soso1999/esp32-s3-ha-voice-satellite/docs/PUBLISHING.md

# Publishing

The owner approved the public GitHub repository `soso1999/esp32-s3-ha-voice-satellite` on 2026-10-15.

Repository: https://github.com/soso1999/esp32-s3-ha-voice-satellite

The repository now uses explicit dual licensing: software, ESPHome YAML files and scripts are licensed under the MIT License; CAD files, 3D models, schematics, documentation, photographs and other non-software content are licensed under the Creative Commons Attribution-ShareAlike 4.0 International License (CC BY-SA 4.0). See `LICENSE.md`, `LICENSE-MIT` and `LICENSE-CC-BY-SA-4.0`.

Do not commit populated secrets or private model/server logs. Revalidate ESPHome configuration after firmware changes, and update documentation and checksums when replacing artifacts. `docs/MANIFEST.sha256` records the packaged project files except itself.

## Upload this update

Unzip the supplied package locally, open its `esp32-s3-ha-voice-satellite` folder, and upload its **contents** to the root of the existing repository. Do not upload the ZIP itself as the source update or add a second nested project folder. Include the hidden `.github` folder (funding button) and `.gitignore`; some file pickers hide them. GitHub's upload page accepts files/folders via drag and drop. Verify that `.github/FUNDING.yml` is included before committing. If your file picker hides it, create that file through GitHub's “Add file → Create new file” with the contents from the package. No existing files need deletion.

The README support links work independently of GitHub's funding button. If the Sponsor button does not appear, check repository Settings → General → Features → Sponsorships.

Keep the repository name `esp32-s3-ha-voice-satellite`. Suggested description: “DIY ESP32-S3 Home Assistant voice satellite with ESPHome, local wake words, Qwen conversation and a 3D-printed enclosure.” Suggested topics: `esp32-s3`, `home-assistant`, `esphome`, `voice-assistant`, `voice-satellite`, `smart-speaker`, `micro-wake-word`, `i2s`, `openscad`, `3d-printing`, `qwen`, `diy-electronics`. Description and topics are repository settings; uploading files does not apply them.
