soso1999/esp32-s3-ha-voice-satellite/docs/PROVENANCE.md

# Source provenance

Prepared 2026-10-15 from the user's referenced conversation “KI in Home Assistant integrieren” and its attachments, plus the actual earlier enclosure work project. No remembered GA-headset or printer-card data was used.

- Final firmware: last complete Stop-enabled YAML, conversation turn 67bad795-94a8-45a2-8aa1-3ab72d7b8fe8. Preserved unchanged; later sensitivity suggestions were not treated as applied changes.
- Operational confirmation: subsequent user reported Stop worked with lower speaker volume and later reported the overall system working well.
- Photos: final four-image upload, turn cf4db80a-133a-451b-a309-d247fd397ab7.
- CAD: original v0.4 files from the earlier work project's `outputs/v04`; cross-checked against the uploaded `esp32_s3_gehaeuse_v04.zip`.
- Physical dimensions: user measurements from the conversation and current request. Coordinate corrections and discrepancies are explicit in `hardware/DIMENSIONS.md`.
- External setup guidance: official ESPHome and Home Assistant documentation checked on packaging date; linked in the relevant guides.

Unresolved details: exact memory module marking/PSRAM capacity, speaker impedance/power, amplifier power/control straps, screw lengths, specific filament/slicer settings of the photographed build, and definitive photo-to-CAD-revision identification. These are not filled with guessed as-built values.
