soso1999/esp32-s3-ha-voice-satellite/images/README.md

# Original build photographs

These four original photographs document the completed ESP32-S3 Home Assistant voice satellite. Only one image is shown on the main repository page to keep the README compact; the complete photo set is collected here.

<p align="center">
  Completed build photo 1
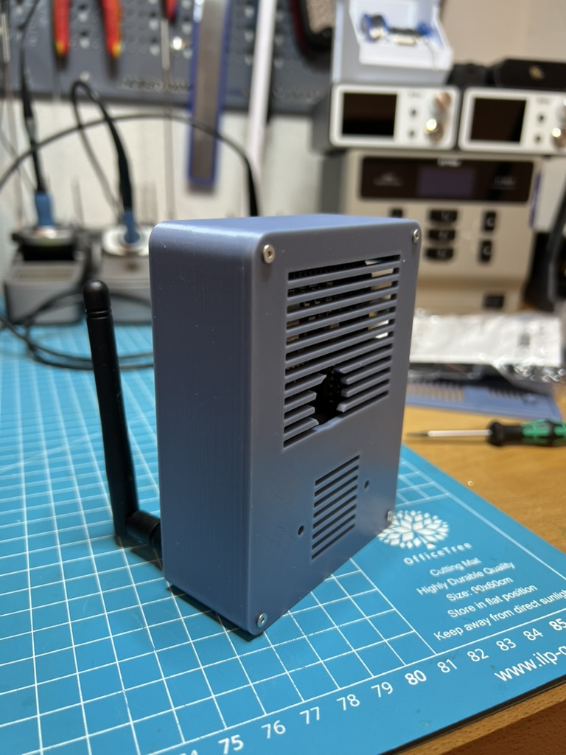
[picture p3: images/build-02.jpeg]
Completed build photo 2
  
</p>

<p align="center">
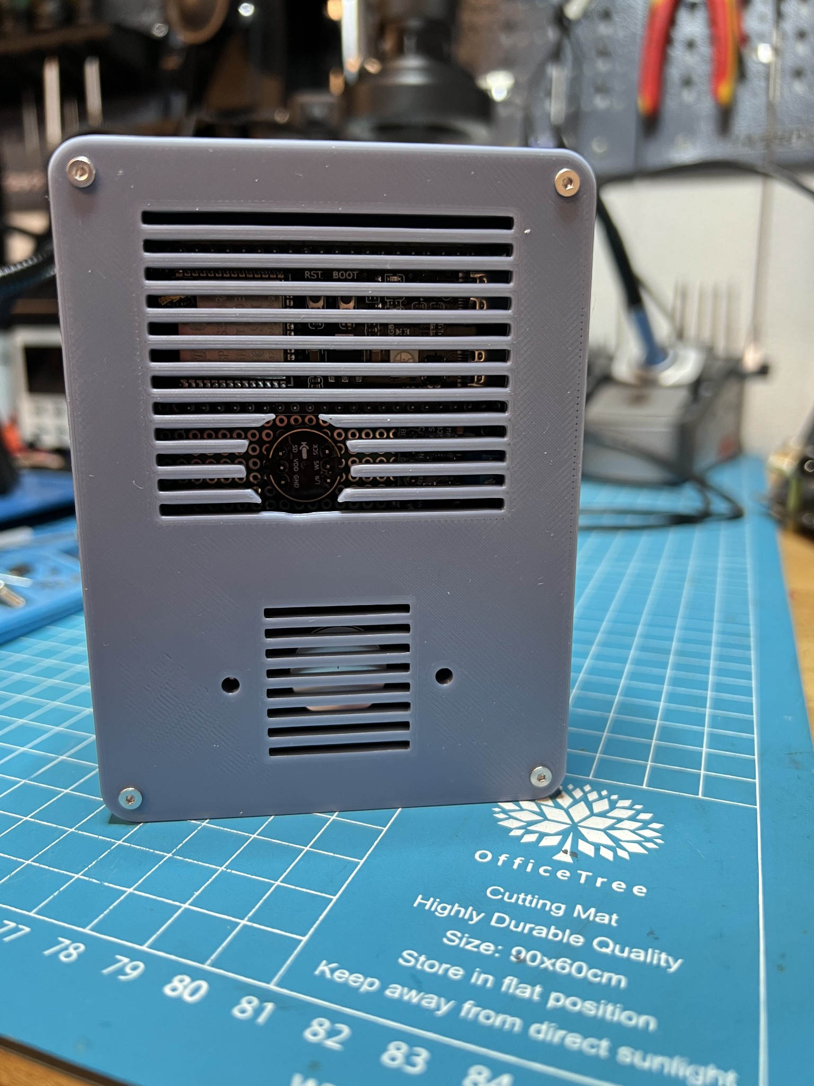
[picture p4: images/build-03.jpg]
Completed build photo 3
  
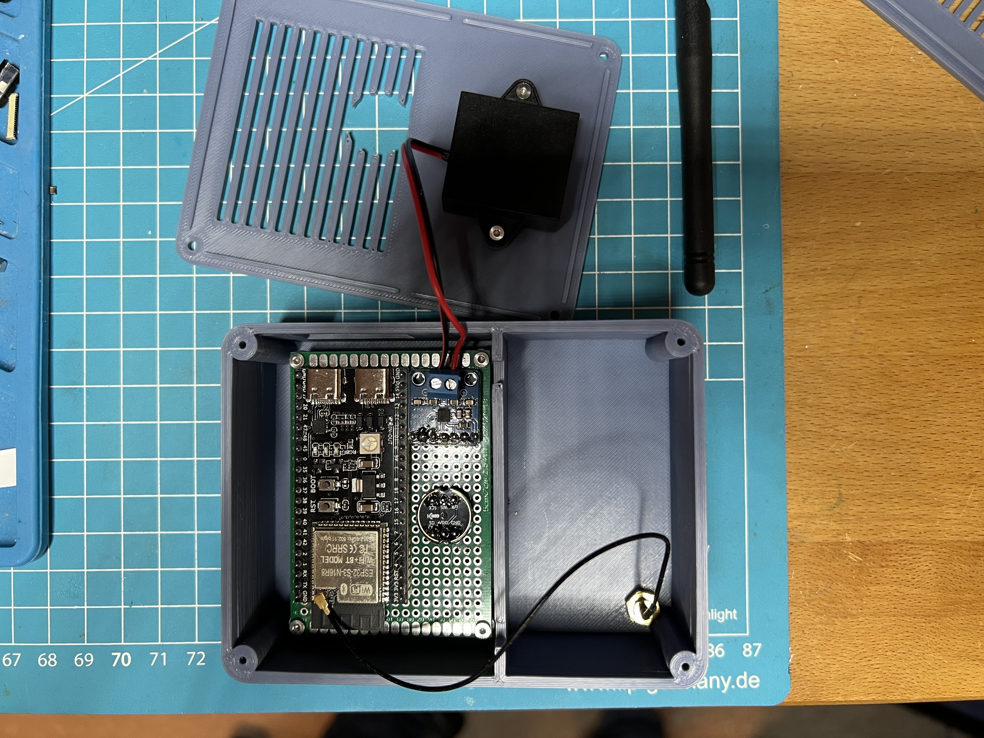
[picture p5: images/build-04.jpg]
Completed build photo 4
  
</p>

## Source files

| Repository file | Original upload |
|---|---|
| `build-01.jpg` | `7EC12A70-4D43-49C6-8FD5-4E7C34E6F7DB.jpg` |
| `build-02.jpeg` | `1B6475AA-E182-4687-AE4E-AAE392DCF8B9_1_105_c.jpeg` |
| `build-03.jpg` | `7204F435-1779-4278-9362-54A0A67C3396.jpg` |
| `build-04.jpg` | `94616138-20AB-4155-9980-914AF7618AA6.jpg` |

SHA-256 hashes in `../docs/MANIFEST.sha256` allow verification of the repository files.

## License

These photographs are licensed under the **Creative Commons Attribution-ShareAlike 4.0 International License (CC BY-SA 4.0)** as part of the repository's non-software content.

See [`../LICENSE.md`](../LICENSE.md) and [`../LICENSE-CC-BY-SA-4.0`](../LICENSE-CC-BY-SA-4.0) for details.

Copyright © 2026 soso1999.
