soso1999/esp32-s3-ha-voice-satellite/cad/massskizze_v04.png

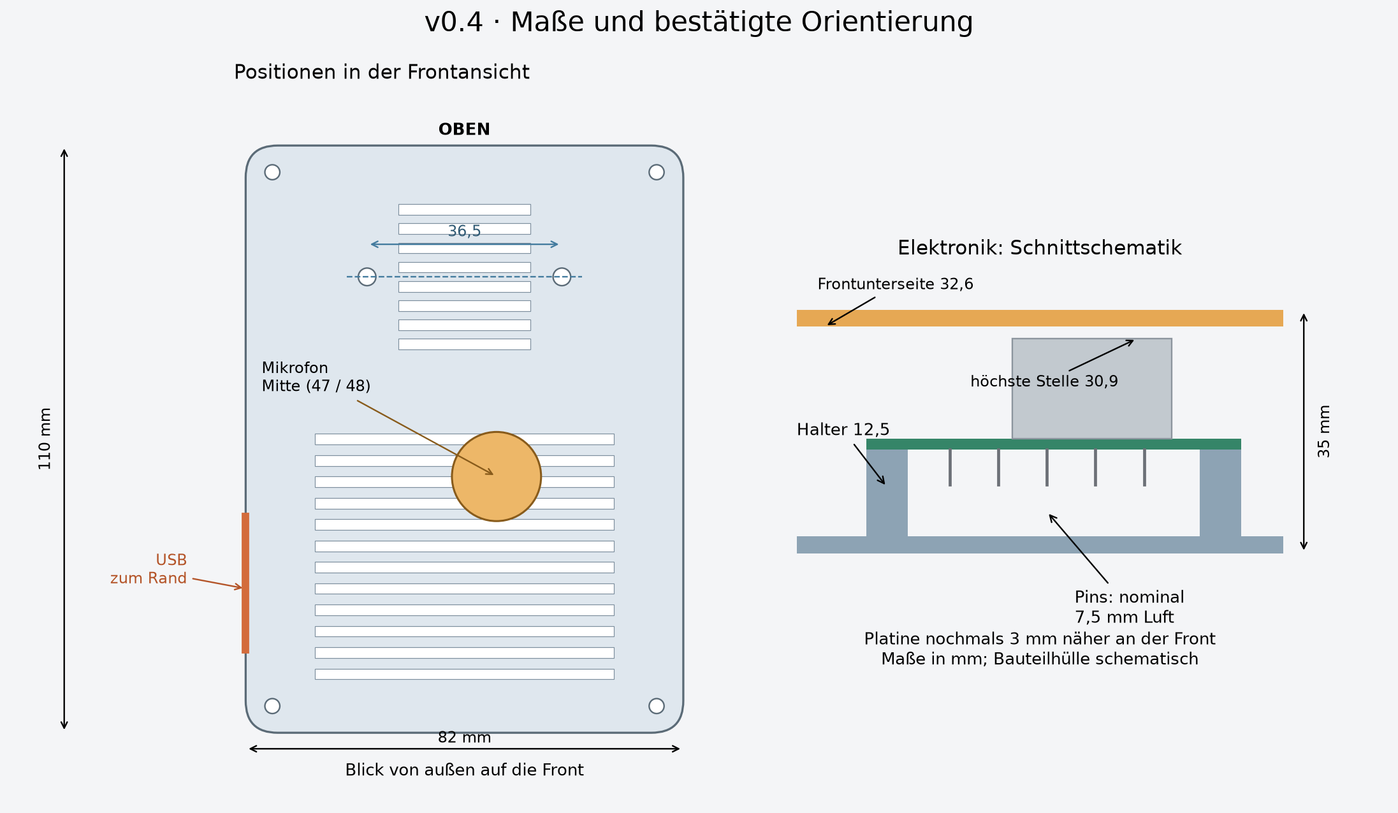
cad/massskizze_v04.png
