soso1999/esp32-s3-ha-voice-satellite/cad/usb_position_v04.png

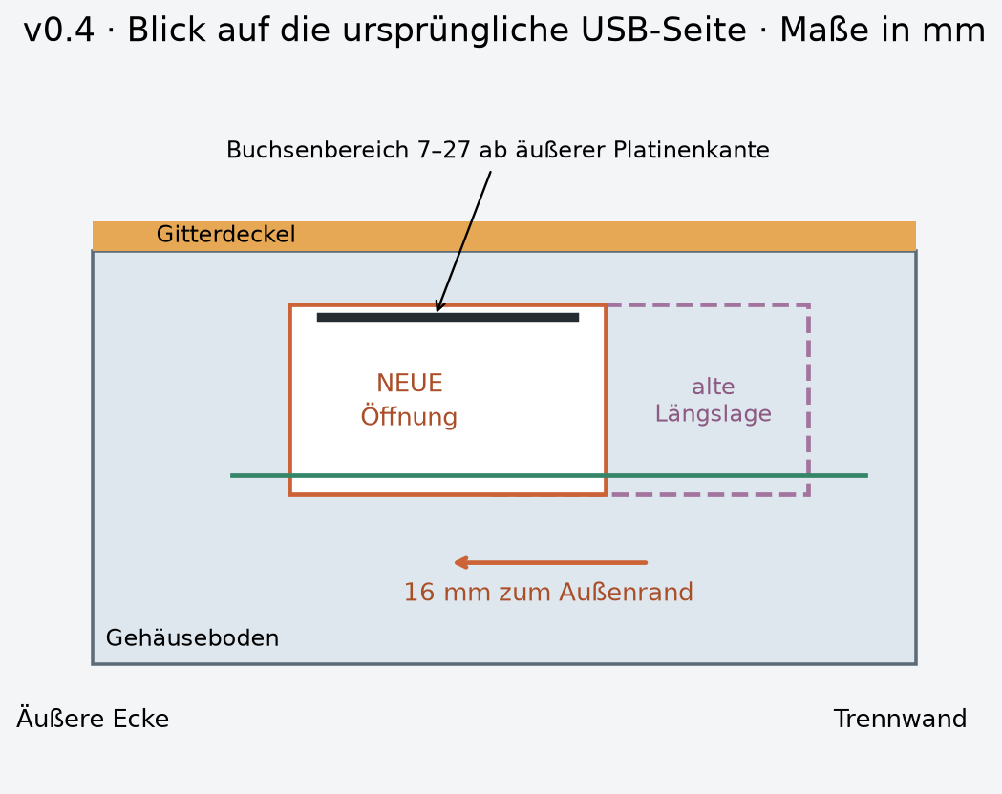
cad/usb_position_v04.png
