soso1999/esp32-s3-ha-voice-satellite/cad/frontgitter_v04.stl

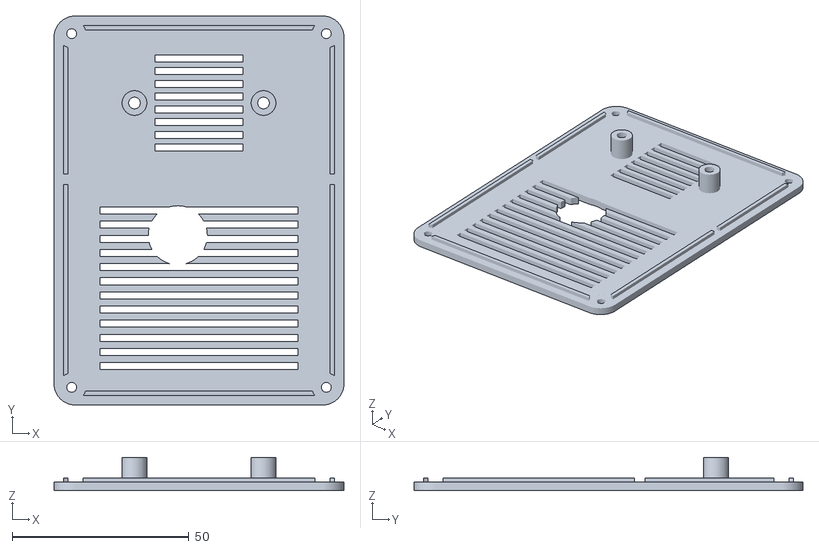
[picture p8: CAD file, 2026-10-15]
cad/frontgitter_v04.stl
82.0 x 110.0 x 9.40
