soso1999/esp32-s3-ha-voice-satellite/(commit log)

2026-10-15 Document completed ESP32-S3 voice satellite with original firmware, CAD and photos
    [frontgitter_v04.stl, gehaeuse_v04.stl, smart_speaker_v04.scad]
2026-10-15 Update MANIFEST.sha256 to remove an entry
    Removed checksum entry for docs/UPLOAD.de.md
