soso1999/esp32-s3-ha-voice-satellite/(notices)

Notices in the files:
README.md:
Software License: MIT
Hardware & Docs: CC BY-SA 4.0
